Pulsar07/ServoTester/(commit log)

2019-06-03 fixed image specs in README
    [ServoTester.ino]
2019-06-06 more specific LED description
